DrBeeps/Strife/Electrical/Hermes/Hermes.pdf

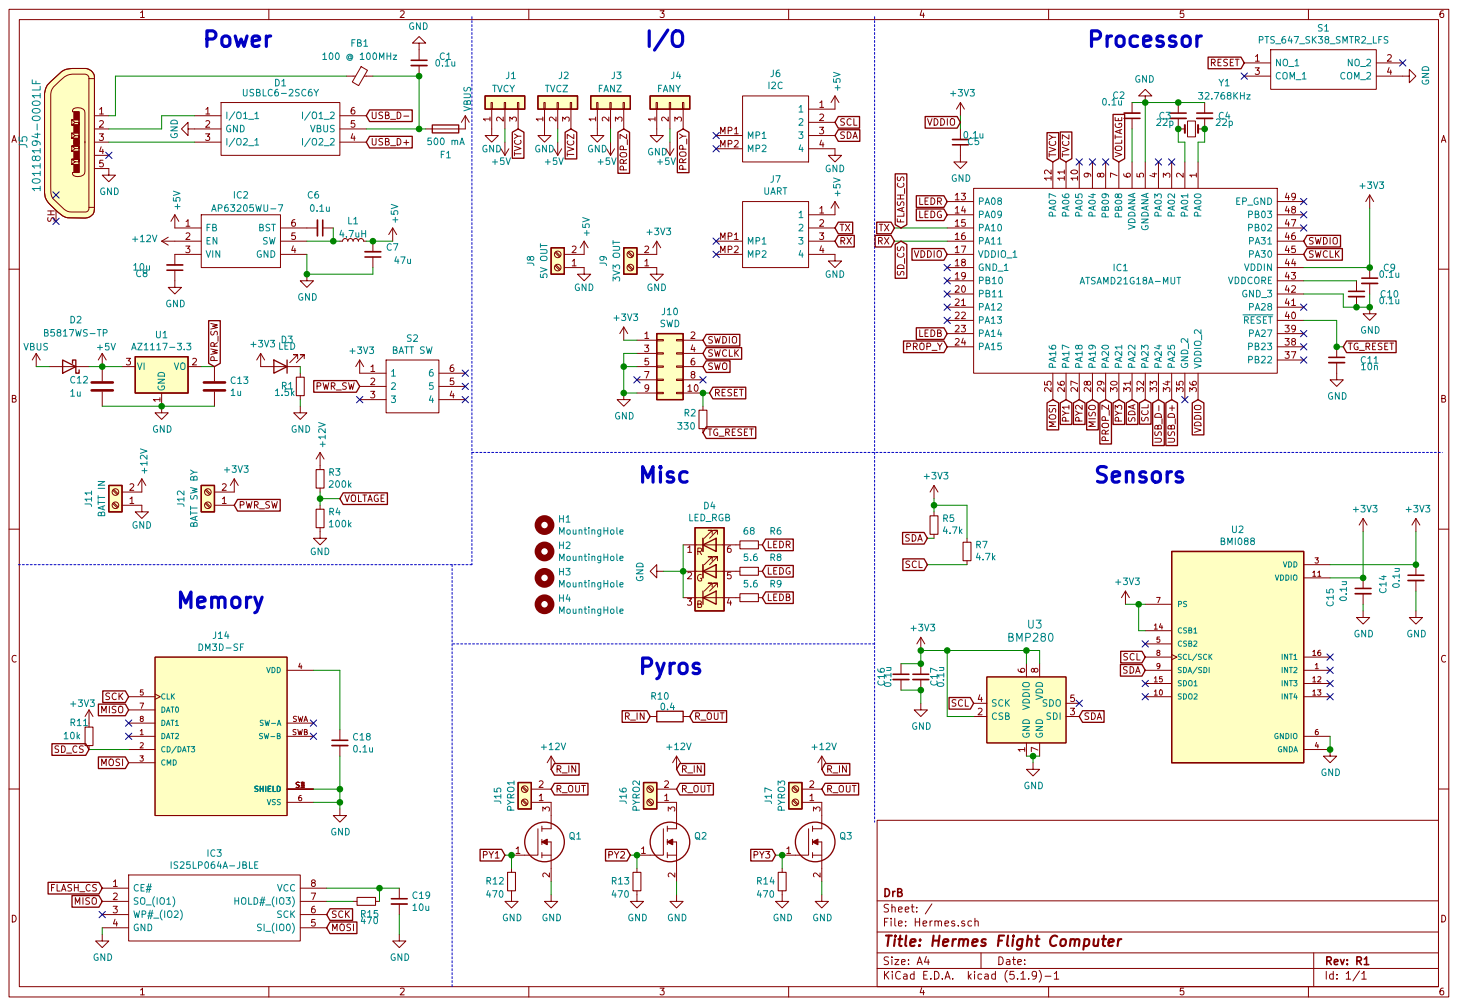
[picture p1: page 1]

1 CSB 2 SDI 3 SCK 4 SDO 5 VDDIO

Id: 1/1 Title: Hermes Flight Computer File: Hermes.sch Sheet: / DrB
