DrBeeps/Strife/Electrical/Titan_R3/Titan_R3.kicad_pcb

## KiCad design Electrical/Titan_R3/Titan_R3.kicad_pcb (2021-04-13)

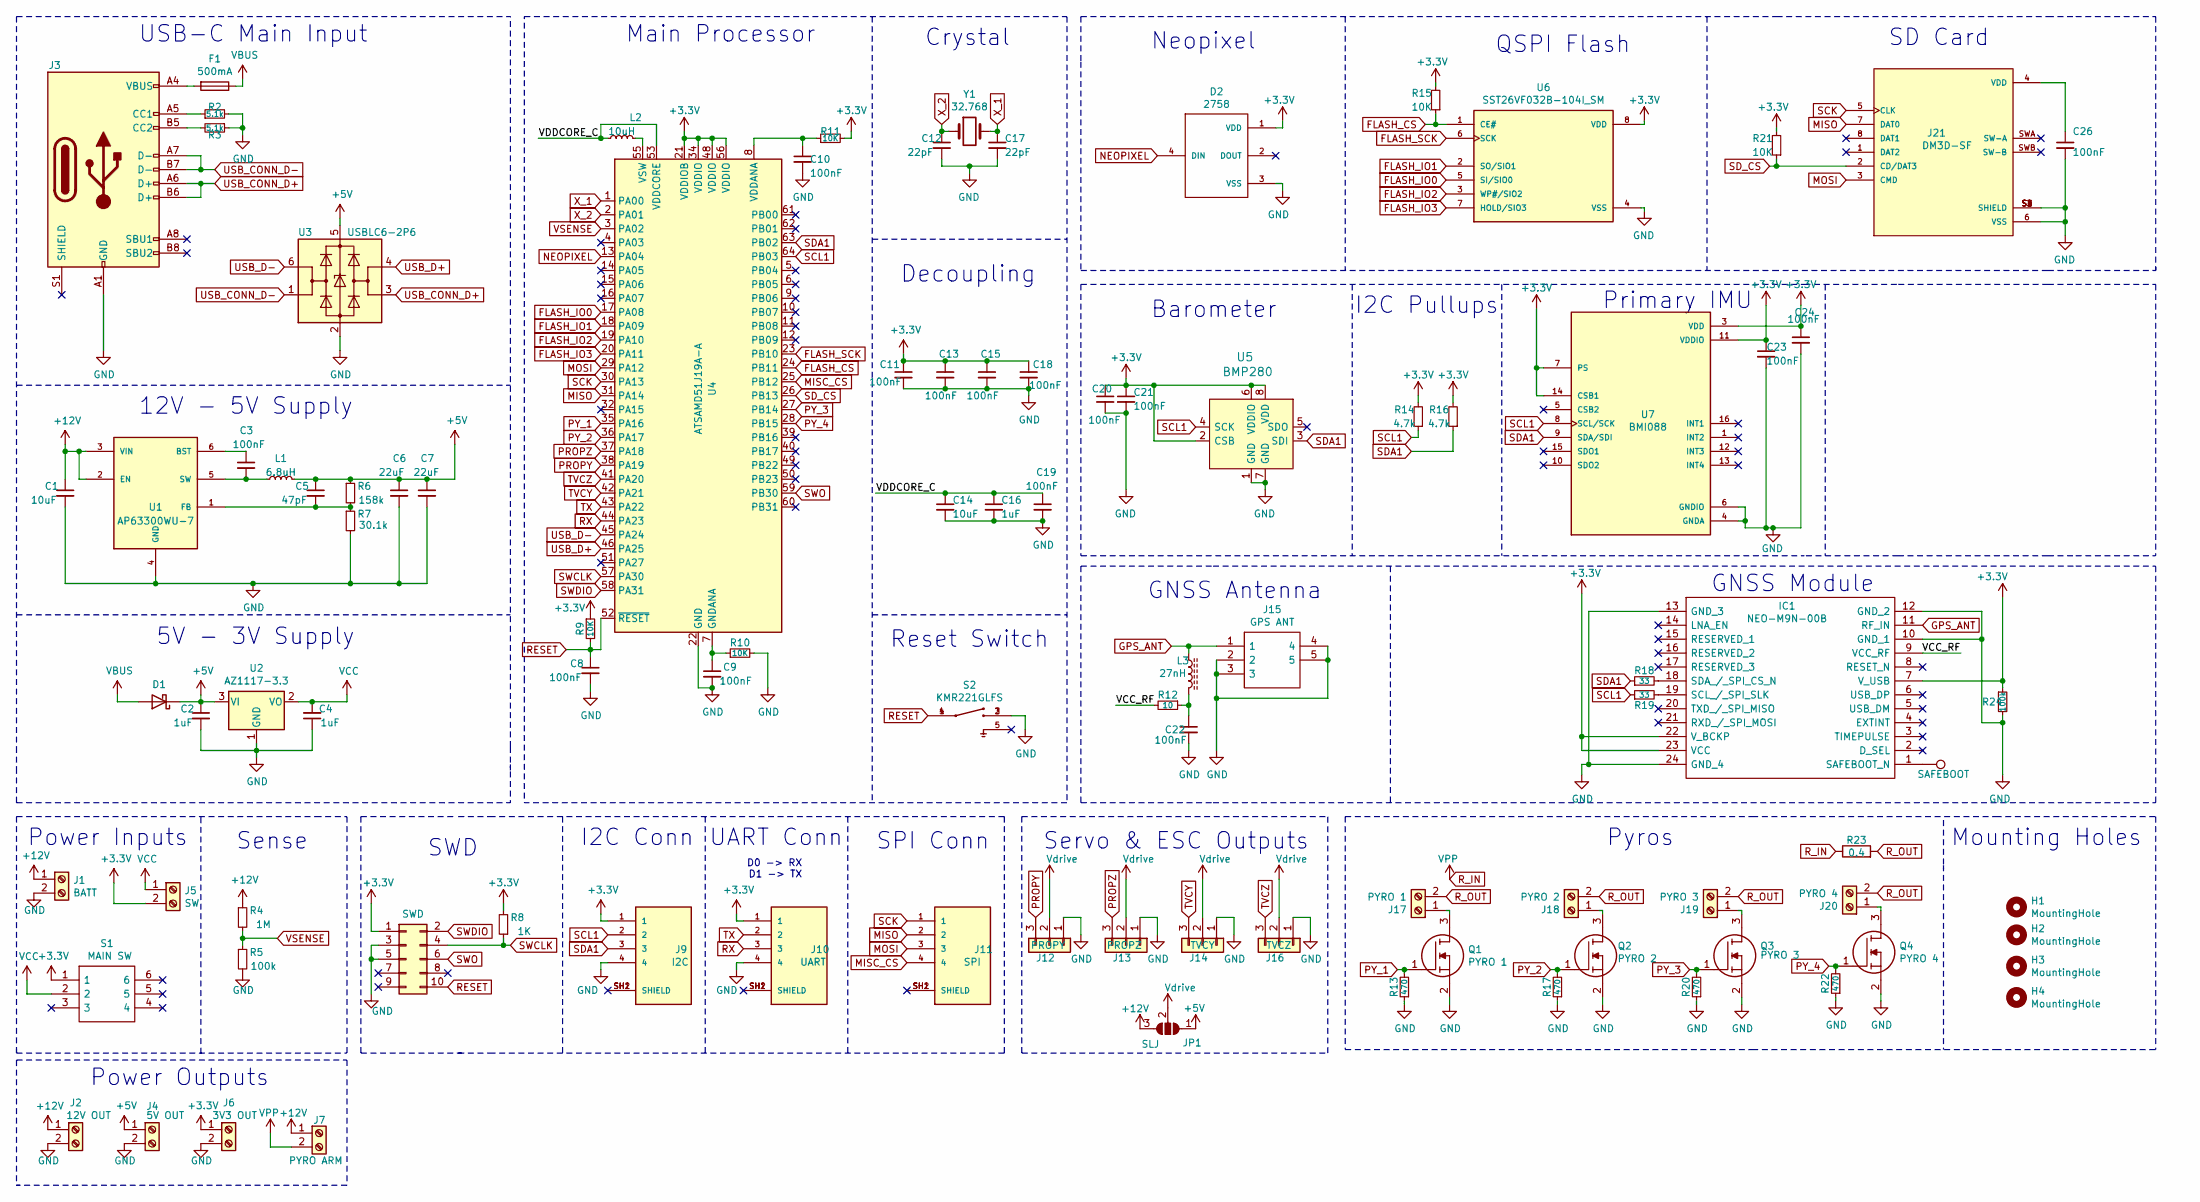
[picture p2: schematic Titan_R3.kicad_sch]

Parts:
C1, C14: 10uF; C_0805_2012Metric
C2, C4, C16: 1uF; C_0603_1608Metric
C3, C8, C9, C10, C11, C13, C15, C18, C19, C20, C21, C22, C23, C24, C26: 100nF; C_0603_1608Metric
C5: 47pF; C_0603_1608Metric
C6, C7: 22uF; C_0805_2012Metric
C12, C17: 22pF; C_0603_1608Metric
D1: D_Schottky; D_SOD-323
D2: 2758; PARTREV 01
F1: 500mA; Fuse_0603_1608Metric
H1, H2, H3, H4: MountingHole; MountingHole_3mm
IC1: NEO-M9N-00B; NEOM9N00B; Manufacturer_Part_Number NEO-M9N-00B; Mouser Part Number 377-NEO-M9N-00B
J1: BATT; TerminalBlock_4Ucon_1x02_P3.50mm_Vertical
J2: 12V OUT; TerminalBlock_4Ucon_1x02_P3.50mm_Vertical
J3: USB_C_Receptacle_USB2.0; USB_C_Receptacle_HRO_TYPE-C-31-M-12
J4: 5V OUT; TerminalBlock_4Ucon_1x02_P3.50mm_Vertical
J5: SW; TerminalBlock_4Ucon_1x02_P3.50mm_Vertical
J6: 3V3 OUT; TerminalBlock_4Ucon_1x02_P3.50mm_Vertical
J7: PYRO ARM; TerminalBlock_4Ucon_1x02_P3.50mm_Vertical
J8: SWD; PinHeader_2x05_P1.27mm_Vertical_SMD
J9: I2C; JST_SM04B-GHS-TB(LF)(SN)-; PARTREV NA
J10: UART; JST_SM04B-GHS-TB(LF)(SN)-; PARTREV NA
J11: SPI; JST_SM04B-GHS-TB(LF)(SN)-; PARTREV NA
J12: PROPY; PinHeader_1x03_P2.54mm_Vertical
J13: PROPZ; PinHeader_1x03_P2.54mm_Vertical
J14: TVCY; PinHeader_1x03_P2.54mm_Vertical
J15: GPS ANT; CONSMA001CG; Manufacturer_Part_Number CONSMA001-C-G; Mouser Part Number 712-CONSMA001-C-G
J16: TVCZ; PinHeader_1x03_P2.54mm_Vertical
J17: PYRO 1; TerminalBlock_4Ucon_1x02_P3.50mm_Vertical
J18: PYRO 2; TerminalBlock_4Ucon_1x02_P3.50mm_Vertical
J19: PYRO 3; TerminalBlock_4Ucon_1x02_P3.50mm_Vertical
J20: PYRO 4; TerminalBlock_4Ucon_1x02_P3.50mm_Vertical
J21: DM3D-SF; HRS_DM3D-SF; PARTREV 2017.1
JP1: SLJ; SolderJumper-3_P1.3mm_Open_Pad1.0x1.5mm
L1: 6.8uH; INDPM7366X300N
L2: 10uH; L_0805_2012Metric
L3: 27nH; L_0603_1608Metric
Q1: PYRO 1; SOT65P210X110-3N; Manufacturer_Part_Number DMN2058UW-7; Mouser Part Number 621-DMN2058UW-7
Q2: PYRO 2; SOT65P210X110-3N; Manufacturer_Part_Number DMN2058UW-7; Mouser Part Number 621-DMN2058UW-7
Q3: PYRO 3; SOT65P210X110-3N; Manufacturer_Part_Number DMN2058UW-7; Mouser Part Number 621-DMN2058UW-7
Q4: PYRO 4; SOT65P210X110-3N; Manufacturer_Part_Number DMN2058UW-7; Mouser Part Number 621-DMN2058UW-7
R2, R3: 5.1k; R_0603_1608Metric
R4: 1M; R_0603_1608Metric
R5, R24: 100k; R_0603_1608Metric
R6: 158k; R_0603_1608Metric
R7: 30.1k; R_0603_1608Metric
R8: 1K; R_0603_1608Metric
R9, R10, R11, R15, R21: 10K; R_0603_1608Metric
R12: 10; R_0603_1608Metric
R13, R17, R20, R22: 470; R_0603_1608Metric
R14, R16: 4.7k; R_0603_1608Metric
R18, R19: 33; R_0603_1608Metric
R23: 0.4; PWR163S25R400FE
S1: MAIN SW; JS202011SCQN; Manufacturer_Part_Number JS202011SCQN; Mouser Part Number 611-JS202011SCQN
S2: KMR221GLFS; SW_KMR221GLFS
TP1: SAFEBOOT; TestPoint_Pad_D1.0mm
U1: AP63300WU-7; SOT95P280X90-6N; PARTREV 2020-04-24
U2: AZ1117-3.3; SOT-223
U3: USBLC6-2P6; SOT-666
U4: ATSAMD51J19A-A; TQFP-64_10x10mm_P0.5mm
U5: BMP280; LGA-8_2x2.5mm_BMP280; MPN BMP280; Digi-Key_PN 828-1064-1-ND
U6: SST26VF032B-104I_SM
U7: BMI088; PARTREV 1.4_092018
Y1: 32.768; CRYSTAL_ECS

Connections:
+3V3: C11.1, C13.1, C15.1, C18.1, C20.1, C21.1, C23.1, C24.1, D2.1 (VDD), IC1.7 (V_USB), IC1.22 (V_BCKP), IC1.23 (VCC), J5.2, J6.1, J8.1, J9.1, J10.1, R8.2, R9.1, R11.2, R14.2, R15.2, R16.2, R21.2, R24.1, S1.1, U4.21 (VDDIOB), U4.34 (VDDIO), U4.48 (VDDIO), U4.56 (VDDIO), U5.2 (CSB), U5.6 (VDDIO), U5.8 (VDD), U6.8 (VDD), U7.3 (VDD), U7.7 (PS), U7.11 (VDDIO), U7.14 (CSB1)
+5V: C2.1, C5.1, C6.1, C7.1, D1.1 (K), J4.1, JP1.1 (A), L1.2, R6.1, U2.3 (VI), U3.5 (VBUS)
+12V: C1.1, J1.1, J2.1, J7.1, JP1.3 (B), R4.1, U1.2 (EN), U1.3 (VIN)
/VCC_RF: IC1.9 (VCC_RF), R12.2
/VDDCORE_C: C14.1, C16.1, C19.1, L2.1, U4.53 (VDDCORE)
FLASH_CS: R15.1, U4.24 (PB11), U6.1 (CE#)
FLASH_IO0: U4.17 (PA08), U6.5 (SI/SIO0)
FLASH_IO1: U4.18 (PA09), U6.2 (SO/SIO1)
FLASH_IO2: U4.19 (PA10), U6.3 (WP#/SIO2)
FLASH_IO3: U4.20 (PA11), U6.7 (HOLD/SIO3)
FLASH_SCK: U4.23 (PB10), U6.6 (SCK)
GND: C1.2, C2.2, C4.1, C6.2, C7.2, C8.2, C9.2, C10.2, C11.2, C12.2, C13.2, C14.2, C15.2, C16.2, C17.2, C18.2, C19.2, C20.2, C21.2, C22.2, C23.2, C24.2, C26.2, D2.3 (VSS), IC1.10 (GND_1), IC1.12 (GND_2), IC1.13 (GND_3), IC1.24 (GND_4), J1.2, J2.2, J3.A1 (GND), J3.A12 (GND), J3.B1 (GND), J3.B12 (GND), J4.2, J6.2, J8.3, J8.5, J9.4, J10.4, J12.1, J13.1, J14.1, J15.2, J15.3, J15.4, J15.5, J16.1, J21.6 (VSS), J21.S1 (SHIELD), J21.S2 (SHIELD), J21.S3 (SHIELD), J21.S4 (SHIELD), Q1.2, Q2.2, Q3.2, Q4.2, R2.2, R3.1, R5.2, R7.2, R10.2, R13.1, R17.1, R20.1, R22.1, R24.2, S2.2, S2.3, U1.4 (GND), U2.1 (GND), U3.2 (GND), U4.22 (GND), U4.33 (GND), U4.47 (GND), U4.54 (GND), U5.1 (GND), U5.7 (GND), U6.4 (VSS), U7.4 (GNDA), U7.6 (GNDIO)
GPS_ANT: IC1.11 (RF_IN), J15.1, L3.1
MISC_CS: J11.4, U4.25 (PB12)
MISO: J11.2, J21.7 (DAT0), U4.31 (PA14)
MOSI: J11.3, J21.3 (CMD), U4.29 (PA12)
NEOPIXEL: D2.4 (DIN), U4.13 (PA04)
unnamed: C3.1, U1.6 (BST)
unnamed: C3.2, L1.1, U1.5 (SW)
unnamed: C5.2, R6.2, R7.1, U1.1 (FB)
unnamed: C9.1, R10.1, U4.7 (GNDANA)
unnamed: C10.1, R11.1, U4.8 (VDDANA)
unnamed: C22.1, L3.2, R12.1
unnamed: C26.1, J21.4 (VDD)
unnamed: F1.2, J3.A4 (VBUS), J3.A9 (VBUS), J3.B4 (VBUS), J3.B9 (VBUS)
unnamed: IC1.1 (SAFEBOOT_N), TP1.1
unnamed: IC1.18 (SDA_/_SPI_CS_N), R18.2
unnamed: IC1.19 (SCL_/_SPI_SLK), R19.2
unnamed: J3.A5 (CC1), R2.1
unnamed: J3.B5 (CC2), R3.2
unnamed: J17.1, Q1.3
unnamed: J18.1, Q2.3
unnamed: J19.1, Q3.3
unnamed: J20.1, Q4.3
unnamed: L2.2, U4.55 (VSW)
PROPY: J12.3, U4.38 (PA19)
PROPZ: J13.3, U4.37 (PA18)
PY_1: Q1.1, R13.2, U4.35 (PA16)
PY_2: Q2.1, R17.2, U4.36 (PA17)
PY_3: Q3.1, R20.2, U4.27 (PB14)
PY_4: Q4.1, R22.2, U4.28 (PB15)
RESET: C8.1, J8.10, R9.2, S2.1, S2.4, U4.52 (~RESET)
RX: J10.3, U4.44 (PA23)
R_IN: J7.2, R23.1
R_OUT: J17.2, J18.2, J19.2, J20.2, R23.2
SCK: J11.1, J21.5 (CLK), U4.30 (PA13)
SCL1: J9.2, R14.1, R19.1, U4.64 (PB03), U5.4 (SCK), U7.8 (SCL/SCK)
SDA1: J9.3, R16.1, R18.1, U4.63 (PB02), U5.3 (SDI), U7.9 (SDA/SDI)
SD_CS: J21.2 (CD/DAT3), R21.1, U4.26 (PB13)
SWCLK: J8.4, R8.1, U4.57 (PA30)
SWDIO: J8.2, U4.58 (PA31)
SWO: J8.6, U4.59 (PB30)
TVCY: J14.3, U4.42 (PA21)
TVCZ: J16.3, U4.41 (PA20)
TX: J10.2, U4.43 (PA22)
USB_CONN_D+: J3.A6 (D+), J3.B6 (D+), U3.3 (I/O2)
USB_CONN_D-: J3.A7 (D-), J3.B7 (D-), U3.1 (I/O1)
USB_D+: U3.4 (I/O2), U4.46 (PA25)
USB_D-: U3.6 (I/O1), U4.45 (PA24)
VBUS: D1.2 (A), F1.1
VCC: C4.2, J5.1, S1.2, U2.2 (VO)
VSENSE: R4.2, R5.1, U4.3 (PA02)
Vdrive: J12.2, J13.2, J14.2, J16.2, JP1.2 (C)
X_1: C17.1, U4.1 (PA00), Y1.2
X_2: C12.1, U4.2 (PA01), Y1.1

Notes on the sheet:
Power Inputs
Power Outputs
USB-C Main Input
12V - 5V Supply
5V - 3V Supply
Sense
SWD
I2C Conn
Main Processor
UART Conn
D0 -> RX D1 -> TX
SPI Conn
Reset Switch
Decoupling
Crystal
Servo & ESC Outputs
GNSS Antenna
Neopixel
Barometer
I2C Pullups
QSPI Flash
Primary IMU
Pyros
GNSS Module
SD Card
Mounting Holes

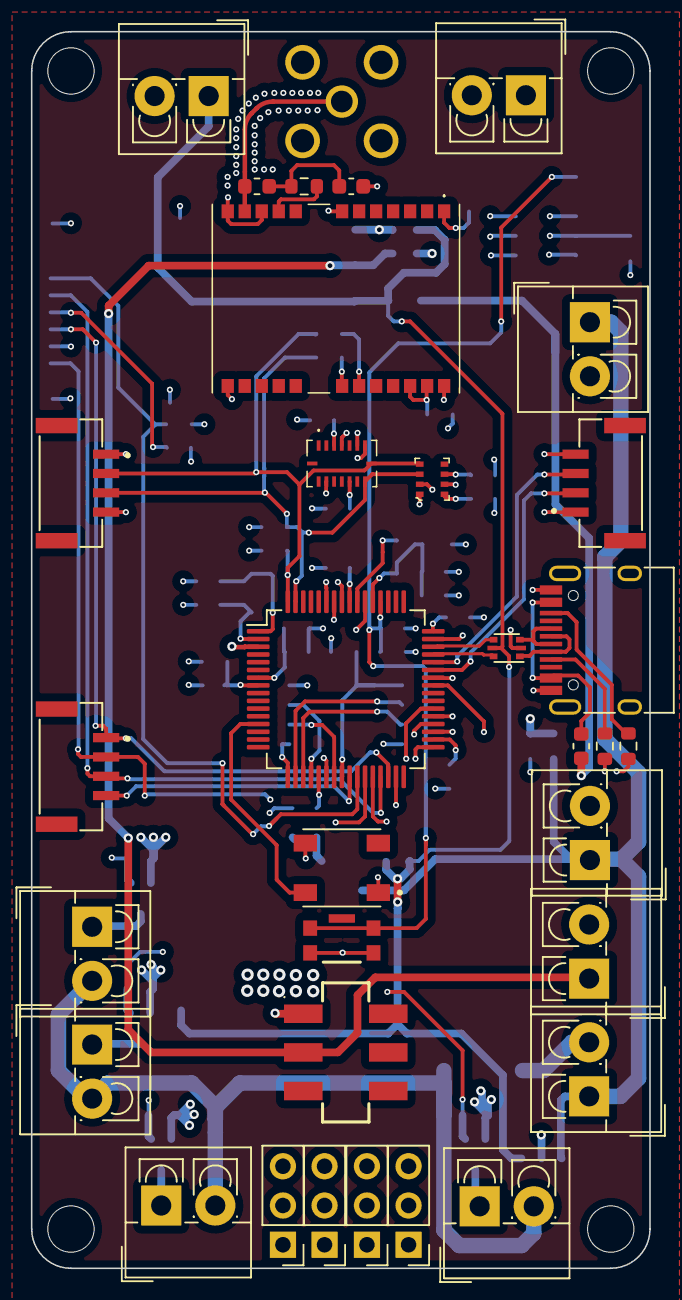
[picture p3: board Titan_R3.kicad_pcb from above]

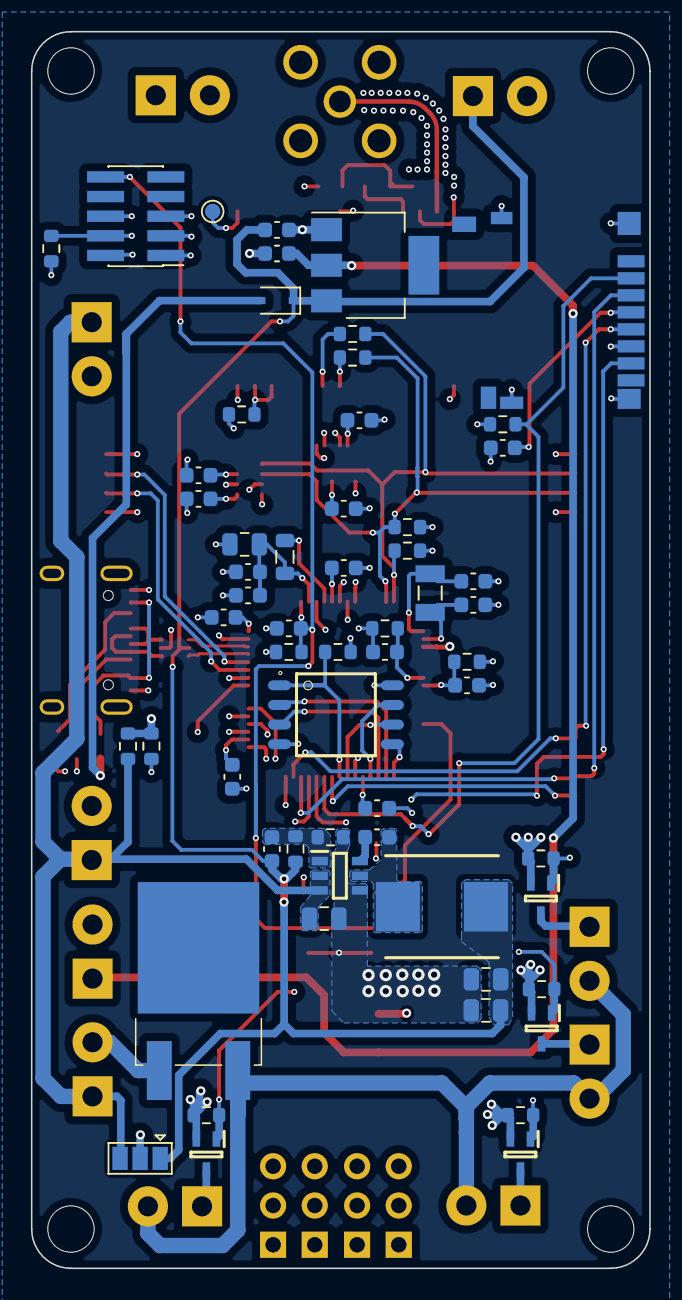
[picture p4: board Titan_R3.kicad_pcb from below]

Board: 4 copper layers, 40.0 x 80.0 mm, 96 parts (59 on the bottom side), 65 nets.
