DrBeeps/Strife/Electrical/Hermes/Hermes.kicad_pcb

## KiCad design Electrical/Hermes/Hermes.kicad_pcb (2021-03-12)

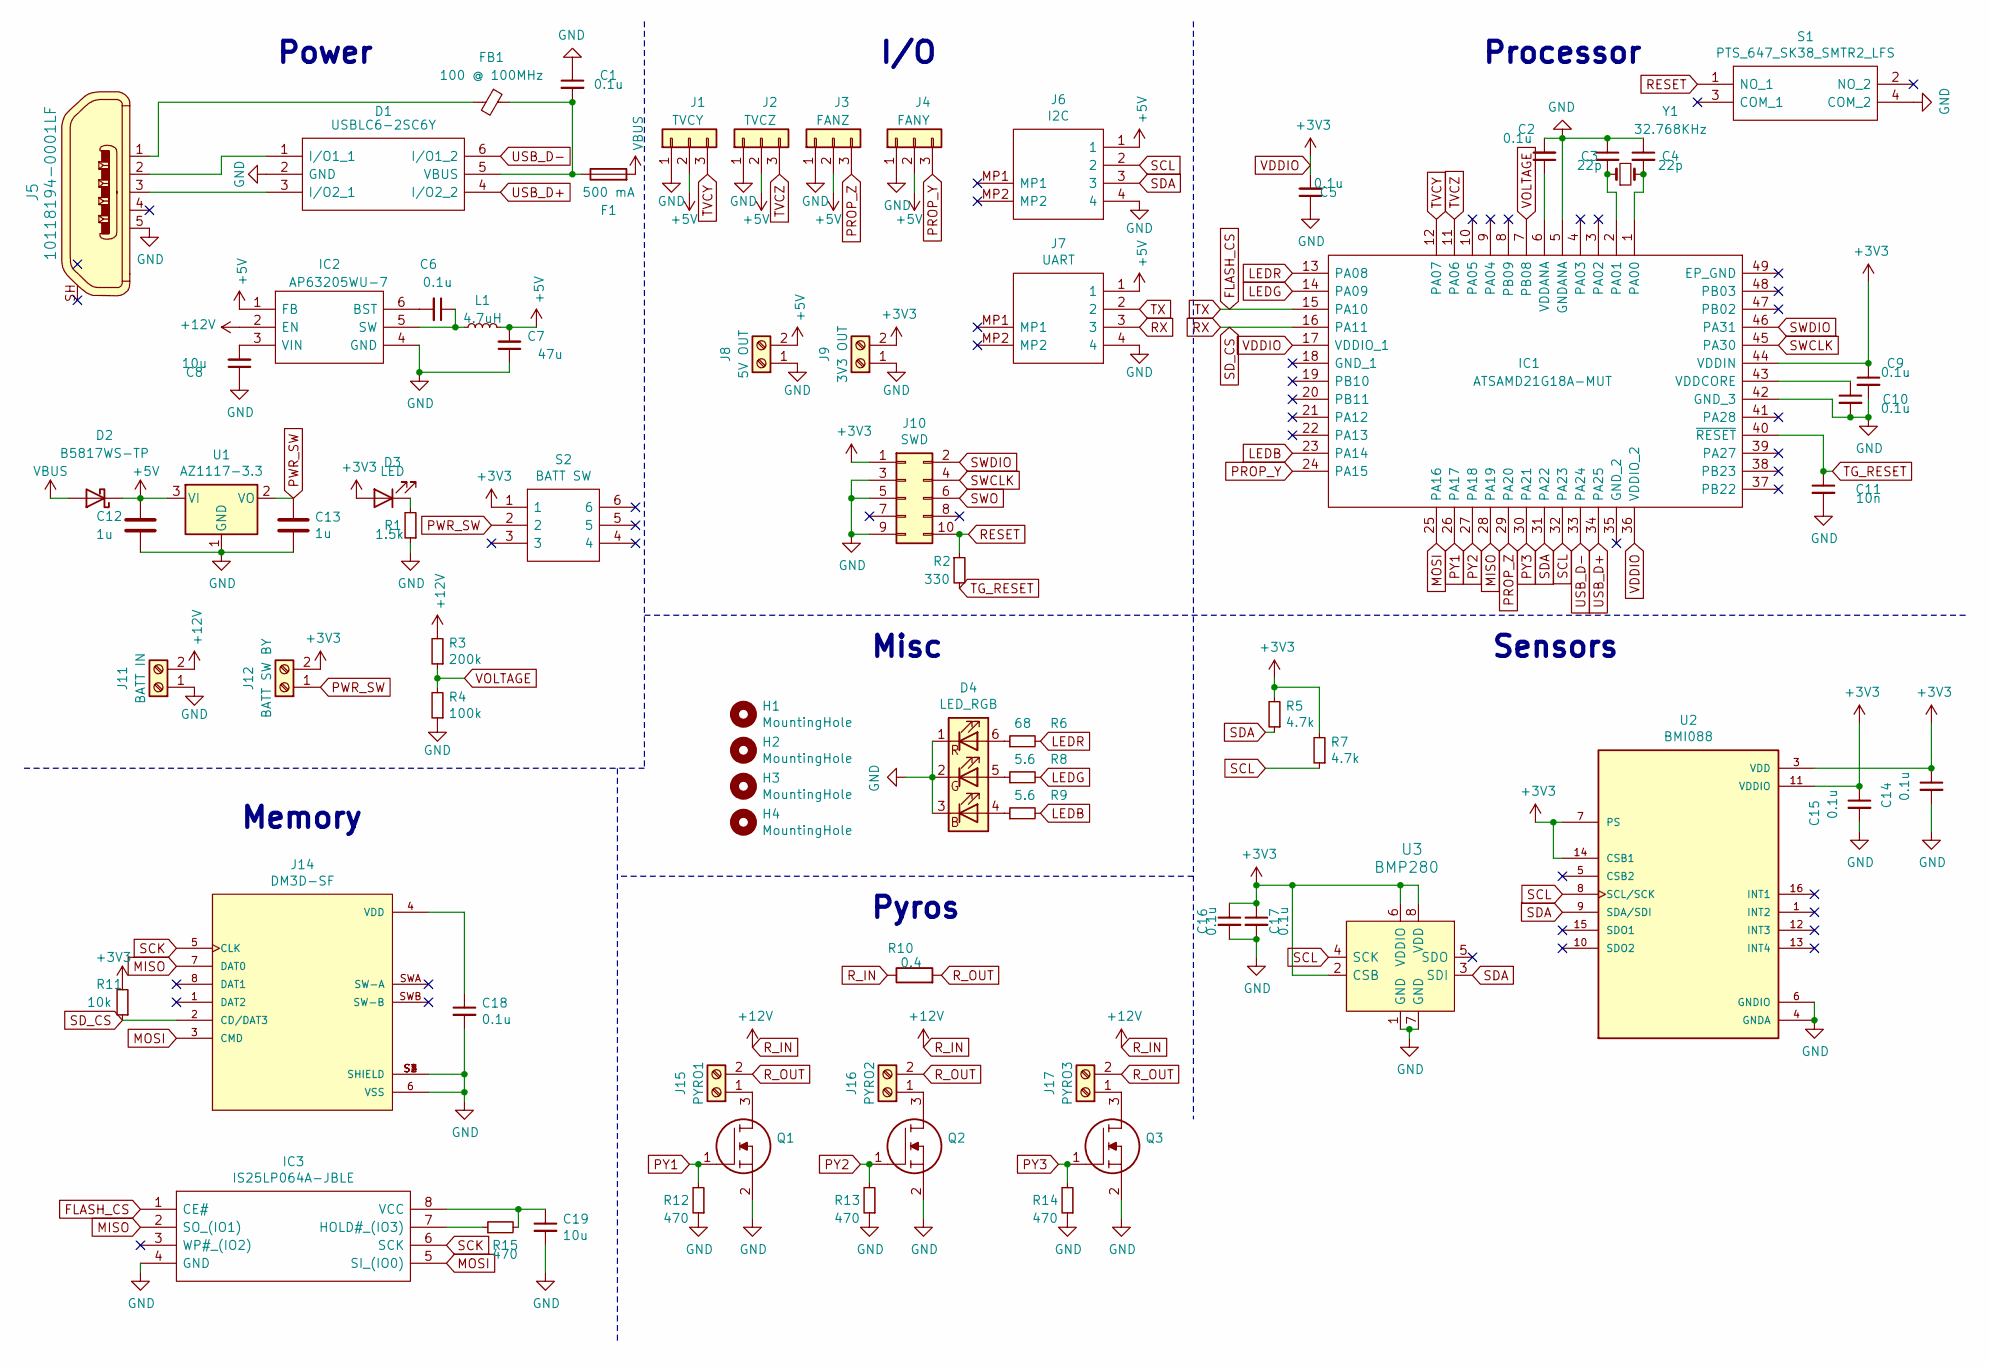
[picture p5: schematic Hermes.sch, Hermes Flight Computer]

Parts:
C1, C6: 0.1u; C_0805_2012Metric
C2, C5, C9, C10, C14, C15, C16, C17, C18: 0.1u; C_0603_1608Metric
C3, C4: 22p; C_0603_1608Metric
C7: 47u; C_1206_3216Metric
C8, C19: 10u; C_0805_2012Metric
C11: 10n; C_0603_1608Metric
C12, C13: 1u; C_0805_2012Metric
D1: USBLC6-2SC6Y; SOT23-6L; Manufacturer_Part_Number USBLC6-2SC6Y; Mouser Part Number 511-USBLC6-2SC6Y
D2: B5817WS-TP; D_SOD-323
D3: LED; LED_0805_2012Metric_Pad1.15x1.40mm_HandSolder
D4: LED_RGB; 150352M173300
F1: 500 mA; Fuse_0805_2012Metric
FB1: 100 @ 100MHz; L_0603_1608Metric
H1, H2, H3, H4: MountingHole; MountingHole_3.2mm_M3
IC1: ATSAMD21G18A-MUT; Manufacturer_Part_Number ATSAMD21G18A-MUT; Mouser Part Number 556-ATSAMD21G18A-MUT
IC2: AP63205WU-7; TSOT-23-6; Manufacturer_Part_Number AP63205WU-7; Mouser Part Number 621-AP63205WU-7
IC3: IS25LP064A-JBLE; SOIC127P790X216-8N; Manufacturer_Part_Number IS25LP064A-JBLE; Mouser Part Number N/A
J1: TVCY; PinHeader_1x03_P2.54mm_Vertical
J2: TVCZ; PinHeader_1x03_P2.54mm_Vertical
J3: FANZ; PinHeader_1x03_P2.54mm_Vertical
J4: FANY; PinHeader_1x03_P2.54mm_Vertical
J5: 10118194-0001LF; AMPHENOL_10118194-0001LF; MPN 10118194-0001LF; Digi-Key_PN 609-4618-1-ND
J6: I2C; 0532617004; Manufacturer_Part_Number 0532617004
J7: UART; 0532617004; Manufacturer_Part_Number 0532617004
J8: 5V OUT; TerminalBlock_4Ucon_1x02_P3.50mm_Vertical
J9: 3V3 OUT; TerminalBlock_4Ucon_1x02_P3.50mm_Vertical
J10: SWD; PinHeader_2x05_P1.27mm_Vertical_SMD
J11: BATT IN; TerminalBlock_4Ucon_1x02_P3.50mm_Vertical
J12: BATT SW BY; TerminalBlock_4Ucon_1x02_P3.50mm_Vertical
J14: DM3D-SF; HRS_DM3D-SF; PARTREV 2017.1
J15: PYRO1; TerminalBlock_4Ucon_1x02_P3.50mm_Vertical
J16: PYRO2; TerminalBlock_4Ucon_1x02_P3.50mm_Vertical
J17: PYRO3; TerminalBlock_4Ucon_1x02_P3.50mm_Vertical
L1: 4.7uH; IND_ECS-MPI4040R2-4R7-R
Q1, Q2, Q3: SOT-23-3; Manufacturer_Part_Number DMN2058UW-7; Mouser Part Number 621-DMN2058UW-7
R1: 1.5k; R_0603_1608Metric
R2: 330; R_0603_1608Metric
R3: 200k; R_0603_1608Metric
R4: 100k; R_0603_1608Metric
R5, R7: 4.7k; R_0603_1608Metric
R6: 68; R_0603_1608Metric
R8, R9: 5.6; R_0603_1608Metric
R10: 0.4; PWR163S25R400FE
R11: 10k; R_0603_1608Metric
R12, R13, R14, R15: 470; R_0603_1608Metric
S1: PTS_647_SK38_SMTR2_LFS; PTS647SK38SMTR2LFS; Manufacturer_Part_Number PTS 647 SK38 SMTR2 LFS
S2: BATT SW; JS202011SCQN; Manufacturer_Part_Number JS202011SCQN; Mouser Part Number 611-JS202011SCQN
U1: AZ1117-3.3; SOT-223
U2: BMI088; PARTREV 1.4_092018
U3: BMP280; LGA-8_2x2.5mm_BMP280; MPN BMP280; Digi-Key_PN 828-1064-1-ND
Y1: 32.768KHz; CRYSTAL_ECS

Connections:
+5V: C7.2, C12.1, D2.1 (K), IC2.1 (FB), J1.2, J2.2, J3.2, J4.2, J6.1, J7.1, J8.2, L1.2, U1.3 (VI)
FLASH_CS: IC1.15 (PA10), IC3.1 (CE#), J7.2
GND: C1.1, C2.2, C3.1, C4.1, C5.1, C7.1, C8.1, C9.2, C10.2, C11.2, C12.2, C13.2, C14.2, C15.2, C16.2, C17.2, C18.2, C19.2, D1.2 (GND), D4.1 (RK), D4.2 (GK), D4.3 (BK), IC1.5 (GNDANA), IC1.42 (GND_3), IC2.4 (GND), IC3.4 (GND), J1.1, J2.1, J3.1, J4.1, J5.5, J6.4, J7.4, J8.1, J9.1, J10.3, J10.5, J10.9, J11.1, J14.6 (VSS), J14.S1 (SHIELD), J14.S2 (SHIELD), J14.S3 (SHIELD), J14.S4 (SHIELD), Q1.2, Q2.2, Q3.2, R1.1, R4.1, R12.1, R13.1, R14.1, S1.4 (COM_2), U1.1 (GND), U2.4 (GNDA), U2.6 (GNDIO), U3.1 (GND), U3.7 (GND)
LEDB: IC1.23 (PA14), R9.2
LEDG: IC1.14 (PA09), R8.2
LEDR: IC1.13 (PA08), R6.2
MISO: IC1.28 (PA19), IC3.2 (SO_(IO1)), J14.7 (DAT0)
MOSI: IC1.25 (PA16), IC3.5 (SI_(IO0)), J14.3 (CMD)
unnamed: C1.2, D1.5 (VBUS), F1.1, FB1.1
unnamed: C2.1, IC1.6 (VDDANA)
unnamed: C3.2, IC1.2 (PA01), Y1.1
unnamed: C4.2, IC1.1 (PA00), Y1.2
unnamed: C6.1, IC2.5 (SW), L1.1
unnamed: C6.2, IC2.6 (BST)
unnamed: C8.2, IC2.3 (VIN)
unnamed: C10.1, IC1.43 (VDDCORE)
unnamed: C18.1, J14.4 (VDD)
unnamed: C19.1, IC3.8 (VCC), R15.2
unnamed: D1.1 (I/O1_1), J5.2
unnamed: D1.3 (I/O2_1), J5.3
unnamed: D3.1 (K), R1.2
unnamed: D4.4 (BA), R9.1
unnamed: D4.5 (GA), R8.1
unnamed: D4.6 (RA), R6.1
unnamed: FB1.2, J5.1
unnamed: IC3.7 (HOLD#_(IO3)), R15.1
unnamed: J15.1, Q1.3
unnamed: J16.1, Q2.3
unnamed: J17.1, Q3.3
PROP_Y: IC1.24 (PA15), J4.3
PROP_Z: IC1.29 (PA20), J3.3
PWR_SW: C13.1, J12.1, S2.2, U1.2 (VO)
PY1: IC1.26 (PA17), Q1.1, R12.2
PY2: IC1.27 (PA18), Q2.1, R13.2
PY3: IC1.30 (PA21), Q3.1, R14.2
RESET: J10.10, R2.1, S1.1 (NO_1)
RX: IC1.16 (PA11), J7.3, J14.2 (CD/DAT3), R11.1
R_IN: IC2.2 (EN), J11.2, R3.2, R10.1
R_OUT: J15.2, J16.2, J17.2, R10.2
SCK: IC3.6 (SCK), J14.5 (CLK)
SCL: IC1.32 (PA23), J6.2, R7.1, U2.8 (SCL/SCK), U3.4 (SCK)
SDA: IC1.31 (PA22), J6.3, R5.1, U2.9 (SDA/SDI), U3.3 (SDI)
SWCLK: IC1.45 (PA30), J10.4
SWDIO: IC1.46 (PA31), J10.2
SWO: J10.6
TG_RESET: C11.1, IC1.40 (~RESET), R2.2
TVCY: IC1.12 (PA07), J1.3
TVCZ: IC1.11 (PA06), J2.3
USB_D+: D1.4 (I/O2_2), IC1.34 (PA25)
USB_D-: D1.6 (I/O1_2), IC1.33 (PA24)
VBUS: D2.2 (A), F1.2
VDDIO: C5.2, C9.1, C14.1, C15.1, C16.1, C17.1, D3.2 (A), IC1.17 (VDDIO_1), IC1.36 (VDDIO_2), IC1.44 (VDDIN), J9.2, J10.1, J12.2, R5.2, R7.2, R11.2, S2.1, U2.3 (VDD), U2.7 (PS), U2.11 (VDDIO), U2.14 (CSB1), U3.2 (CSB), U3.6 (VDDIO), U3.8 (VDD)
VOLTAGE: IC1.7 (PB08), R3.1, R4.2

Notes on the sheet:
Power
I/O
Processor
Misc
Memory
Pyros
Sensors

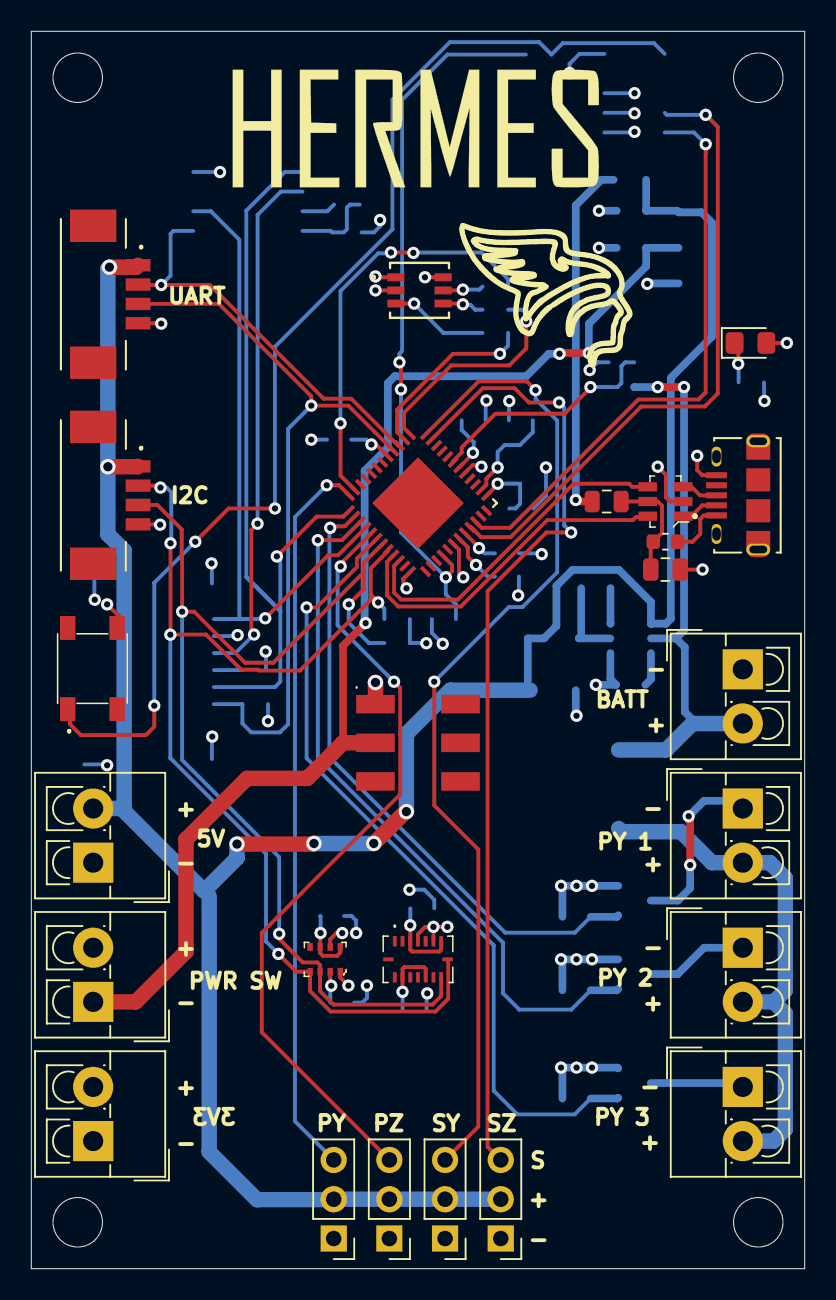
[picture p6: board Hermes.kicad_pcb from above]

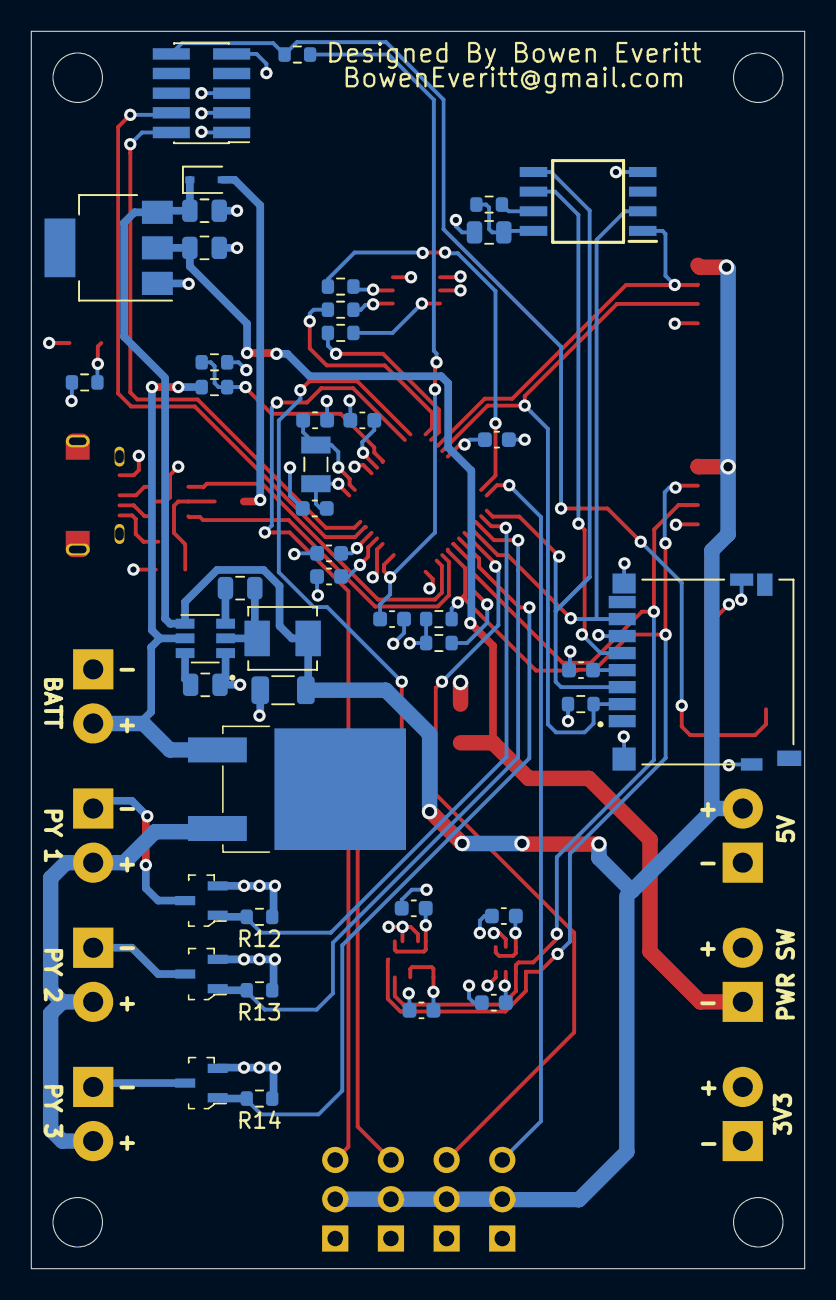
[picture p7: board Hermes.kicad_pcb from below]

Board: 4 copper layers, 50.0 x 80.0 mm, 73 parts (44 on the bottom side), 52 nets.
