DrBeeps/Strife/(commit log)

2021-03-12 worked more on routing
    [Titan_R3.kicad_pcb]
2021-04-13 major flight software changes
    [Titan_R3.kicad_pcb, Titan_R3.kicad_sch]
